team-rocket-chipathon/lattice-coprocessor/README.md

# lattice-coprocessor
LWE Accelerator Targeting Tapeout-ready IC for Encryption
