team-rocket-chipathon/lattice-coprocessor/(commit log)

2026-06-23 trng: Add SPI interface definition
2026-06-23 interfaces/spi: Update pin names
2026-06-23 interfaces/spi: Fix typo
2026-06-24 Add SPI subordinate controller: RTL, cocotb tests, register-map docs
2026-06-24 SPI: rename clk->sclk; finalize interface + docs
2026-06-29 Add initial bandgap reference design
    [test_bgr.sch]
